LessNick/Astarta-ESP32/misc/ESP32-SIO.pdf

# ESP-32 connect Atari SIO

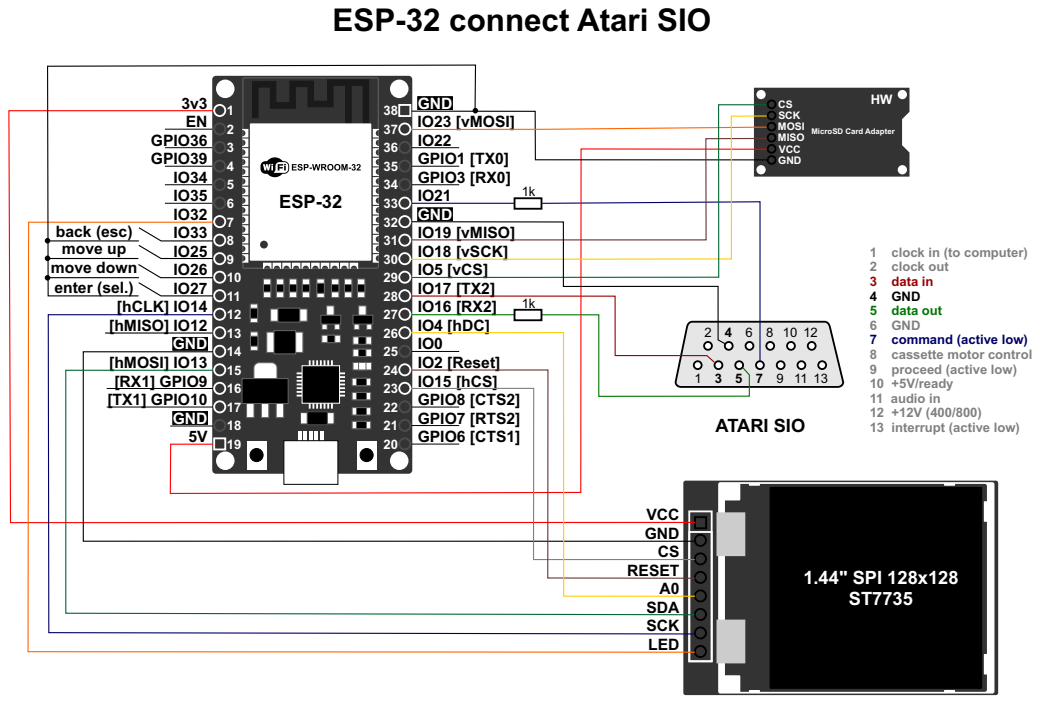
[picture p16: page 1]
3v3 EN GPIO36 GPIO39 IO34 IO35 IO32 IO33 IO25 IO26 IO27 [hCLK] IO14 [hMISO] IO12 GND [hMOSI] IO13 [RX1] GPIO9 [TX1] GPIO10 GND 5V; GND IO23 [vMOSI] IO22 GPIO1 [TX0] GPIO3 [RX0] IO21 GND IO19 [vMISO] IO18 [vSCK] IO5 [vCS]; IO4 [hDC] IO0 IO2 [Reset] IO15 [hCS]; GPIO7 [RTS2] GPIO6 [CTS1]; ESP-32; GPIO8 [CTS2]; ATARI SIO; 1.44" SPI 128x128 ST7735; VCC GND CS RESET A0 SDA SCK LED; enter (sel.); back (esc) move up move down; CS SCK MOSI MISO VCC GND

MicroSD Card Adapter

1 clock in (to computer)
2 clock out
3 data in
4 GND
5 data out
6 GND
7 command (active low)
8 cassette motor control
9 proceed (active low)
10 +5V/ready
11 audio in
13 interrupt (active low)

# Подключение ESP-32 к Atari

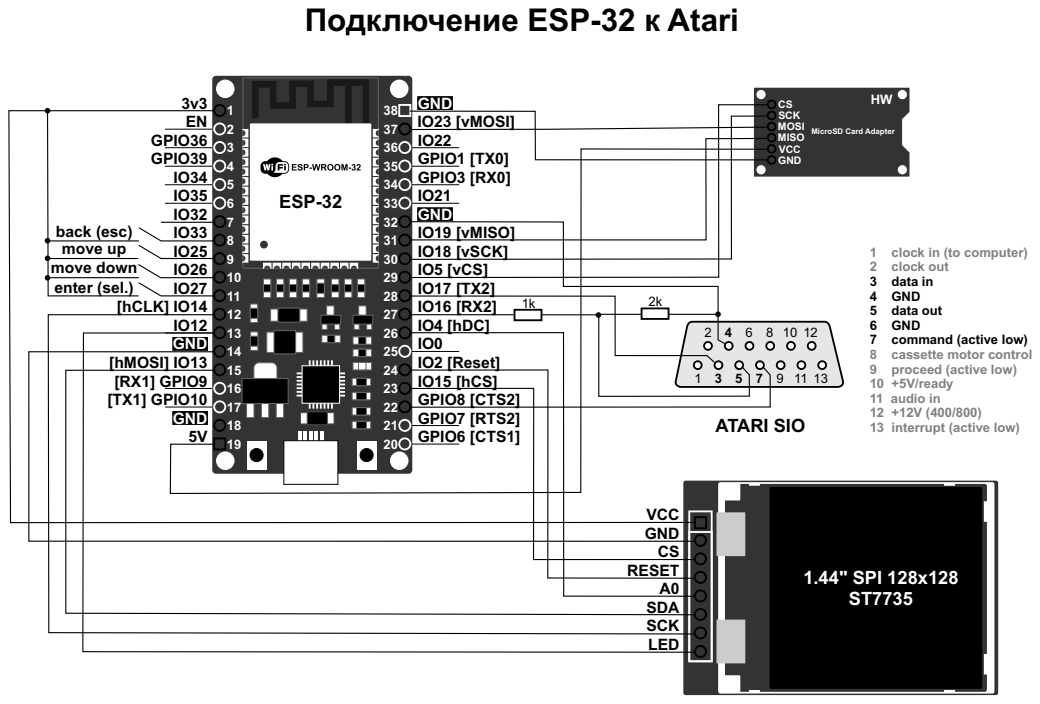
[picture p17: page 2]
3v3 EN GPIO36 GPIO39 IO34 IO35 IO32 IO33 IO25 IO26 IO27 [hCLK] IO14 IO12 GND [hMOSI] IO13 [RX1] GPIO9 [TX1] GPIO10 GND 5V; GND IO23 [vMOSI] IO22 GPIO1 [TX0] GPIO3 [RX0] IO21 GND IO19 [vMISO] IO18 [vSCK] IO5 [vCS]; IO4 [hDC] IO0 IO2 [Reset] IO15 [hCS]; GPIO7 [RTS2] GPIO6 [CTS1]; ESP-32; GPIO8 [CTS2]; ATARI SIO; 1.44" SPI 128x128 ST7735; VCC GND CS RESET A0 SDA SCK LED; enter (sel.); back (esc) move up move down; CS SCK MOSI MISO VCC GND

MicroSD Card Adapter

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
