LessNick/Astarta-ESP32/src/icons24_rgb.h

#ifndef ICONS24_h
#define ICONS24_h

const static uint8_t iconCassette[] = {
	0x95, 0xbe, 0x95, 0xbe, 0x95, 0xbe, 0x95, 0xbe, 0x95, 0xbe, 0x95, 0xbe, 0x95, 0xbe, 0x95, 0xbe, 0x95, 0xbe, 0x95, 0xbe, 0x95, 0xbe, 0x95, 0xbe, 0x95, 0xbe, 0x95, 0xbe, 0x95, 0xbe, 0x95, 0xbe, 0x95, 0xbe, 0x95, 0xbe, 0x95, 0xbe, 0x95, 0xbe, 0x95, 0xbe, 0x95, 0xbe, 0x95, 0xbe, 0x95, 0xbe, 
	0x95, 0xbe, 0x95, 0xbe, 0x95, 0xbe, 0x95, 0xbe, 0x95, 0xbe, 0x95, 0xbe, 0x95, 0xbe, 0x95, 0xbe, 0x95, 0xbe, 0x95, 0xbe, 0x95, 0xbe, 0x95, 0xbe, 0x95, 0xbe, 0x95, 0xbe, 0x95, 0xbe, 0x95, 0xbe, 0x95, 0xbe, 0x95, 0xbe, 0x95, 0xbe, 0x95, 0xbe, 0x95, 0xbe, 0x95, 0xbe, 0x95, 0xbe, 0x95, 0xbe, 
	0x95, 0xbe, 0x95, 0xbe, 0x95, 0xbe, 0x95, 0xbe, 0x95, 0xbe, 0x95, 0xbe, 0x95, 0xbe, 0x95, 0xbe, 0x95, 0xbe, 0x95, 0xbe, 0x95, 0xbe, 0x95, 0xbe, 0x95, 0xbe, 0x95, 0xbe, 0x95, 0xbe, 0x95, 0xbe, 0x95, 0xbe, 0x95, 0xbe, 0x95, 0xbe, 0x95, 0xbe, 0x95, 0xbe, 0x95, 0xbe, 0x95, 0xbe, 0x95, 0xbe, 
	0x95, 0xbe, 0x95, 0xbe, 0x95, 0xbe, 0x95, 0xbe, 0x95, 0xbe, 0x95, 0xbe, 0x95, 0xbe, 0x95, 0xbe, 0x95, 0xbe, 0x95, 0xbe, 0x95, 0xbe, 0x95, 0xbe, 0x95, 0xbe, 0x95, 0xbe, 0x95, 0xbe, 0x95, 0xbe, 0x95, 0xbe, 0x95, 0xbe, 0x95, 0xbe, 0x95, 0xbe, 0x95, 0xbe, 0x95, 0xbe, 0x95, 0xbe, 0x95, 0xbe, 
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
};

#endif
