LessNick/Astarta-ESP32/src/icons_rgb.h

#ifndef ICONS_h
#define ICONS_h

const static uint8_t iconCas0[] = {
	0x00, 0x00, 0x00, 0x00, 0x00, 0x00, 0x00, 0x00, 0x00, 0x00, 0x00, 0x00, 0x00, 0x00, 0x00, 0x00, 0x00, 0x00, 0x00, 0x00, 0x00, 0x00, 0x00, 0x00, 
	0x00, 0x00, 0x00, 0x00, 0x00, 0x00, 0x00, 0x00, 0x00, 0x00, 0x00, 0x00, 0x00, 0x00, 0x00, 0x00, 0x00, 0x00, 0x00, 0x00, 0x00, 0x00, 0x00, 0x00, 
	0x2a, 0x35, 0x2a, 0x35, 0x2a, 0x35, 0x2a, 0x35, 0x2a, 0x35, 0x2a, 0x35, 0x2a, 0x35, 0x2a, 0x35, 0x2a, 0x35, 0x2a, 0x35, 0x2a, 0x35, 0x2a, 0x35, 
	0x2a, 0x35, 0x64, 0x5c, 0x64, 0x5c, 0x64, 0x5c, 0x64, 0x5c, 0x64, 0x5c, 0x64, 0x5c, 0x64, 0x5c, 0x64, 0x5c, 0x64, 0x5c, 0x64, 0x5c, 0x2a, 0x35, 
	0x2a, 0x35, 0x64, 0x5c, 0x19, 0x50, 0x00, 0x00, 0x64, 0x5c, 0x64, 0x5c, 0x64, 0x5c, 0x64, 0x5c, 0x19, 0x50, 0x00, 0x00, 0x64, 0x5c, 0x2a, 0x35, 
	0x2a, 0x35, 0x64, 0x5c, 0x00, 0x00, 0x00, 0x00, 0x64, 0x5c, 0x43, 0x19, 0x43, 0x19, 0x64, 0x5c, 0x00, 0x00, 0x00, 0x00, 0x64, 0x5c, 0x2a, 0x35, 
	0x2a, 0x35, 0x64, 0x5c, 0x64, 0x5c, 0x64, 0x5c, 0x64, 0x5c, 0x64, 0x5c, 0x64, 0x5c, 0x64, 0x5c, 0x64, 0x5c, 0x64, 0x5c, 0x64, 0x5c, 0x2a, 0x35, 
	0x2a, 0x35, 0x2a, 0x35, 0x43, 0x19, 0x43, 0x19, 0x43, 0x19, 0x43, 0x19, 0x43, 0x19, 0x43, 0x19, 0x43, 0x19, 0x43, 0x19, 0x2a, 0x35, 0x2a, 0x35, 
	0x2a, 0x35, 0x43, 0x19, 0x2a, 0x35, 0x2a, 0x35, 0x2a, 0x35, 0x2a, 0x35, 0x2a, 0x35, 0x2a, 0x35, 0x2a, 0x35, 0x2a, 0x35, 0x43, 0x19, 0x2a, 0x35, 
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
	0x64, 0x5c, 0x64, 0x5c, 0x19, 0x50, 0x00, 0x00, 0x00, 0x00, 0x00, 0x00, 0x00, 0x00, 0x00, 0x00, 0x00, 0x00, 0x00, 0x00, 0x00, 0x00, 0x00, 0x00
};

#endif
