LessNick/Astarta-ESP32/src/icons.h

#ifndef ICONS_h
#define ICONS_h

static uint8_t const iconCas0[] = {
	0x00, 0x00, 0x00, 0x00, 0x00, 0x00, 0x00, 0x00, 0x00, 0x00, 0x00, 0x00, 0x00, 0x00, 0x00, 0x00, 0x00, 0x00, 0x00, 0x00, 0x00, 0x00, 0x00, 0x00, 
	0x00, 0x00, 0x00, 0x00, 0x00, 0x00, 0x00, 0x00, 0x00, 0x00, 0x00, 0x00, 0x00, 0x00, 0x00, 0x00, 0x00, 0x00, 0x00, 0x00, 0x00, 0x00, 0x00, 0x00, 
	0x35, 0x2a, 0x35, 0x2a, 0x35, 0x2a, 0x35, 0x2a, 0x35, 0x2a, 0x35, 0x2a, 0x35, 0x2a, 0x35, 0x2a, 0x35, 0x2a, 0x35, 0x2a, 0x35, 0x2a, 0x35, 0x2a, 
	0x35, 0x2a, 0x5c, 0x64, 0x5c, 0x64, 0x5c, 0x64, 0x5c, 0x64, 0x5c, 0x64, 0x5c, 0x64, 0x5c, 0x64, 0x5c, 0x64, 0x5c, 0x64, 0x5c, 0x64, 0x35, 0x2a, 
	0x35, 0x2a, 0x5c, 0x64, 0x50, 0x19, 0x00, 0x00, 0x5c, 0x64, 0x5c, 0x64, 0x5c, 0x64, 0x5c, 0x64, 0x50, 0x19, 0x00, 0x00, 0x5c, 0x64, 0x35, 0x2a, 
	0x35, 0x2a, 0x5c, 0x64, 0x00, 0x00, 0x00, 0x00, 0x5c, 0x64, 0x19, 0x43, 0x19, 0x43, 0x5c, 0x64, 0x00, 0x00, 0x00, 0x00, 0x5c, 0x64, 0x35, 0x2a, 
	0x35, 0x2a, 0x5c, 0x64, 0x5c, 0x64, 0x5c, 0x64, 0x5c, 0x64, 0x5c, 0x64, 0x5c, 0x64, 0x5c, 0x64, 0x5c, 0x64, 0x5c, 0x64, 0x5c, 0x64, 0x35, 0x2a, 
	0x35, 0x2a, 0x35, 0x2a, 0x19, 0x43, 0x19, 0x43, 0x19, 0x43, 0x19, 0x43, 0x19, 0x43, 0x19, 0x43, 0x19, 0x43, 0x19, 0x43, 0x35, 0x2a, 0x35, 0x2a, 
	0x35, 0x2a, 0x19, 0x43, 0x35, 0x2a, 0x35, 0x2a, 0x35, 0x2a, 0x35, 0x2a, 0x35, 0x2a, 0x35, 0x2a, 0x35, 0x2a, 0x35, 0x2a, 0x19, 0x43, 0x35, 0x2a, 
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
	0x5c, 0x64, 0x5c, 0x64, 0x50, 0x19, 0x00, 0x00, 0x00, 0x00, 0x00, 0x00, 0x00, 0x00, 0x00, 0x00, 0x00, 0x00, 0x00, 0x00, 0x00, 0x00, 0x00, 0x00
};

#endif
