LessNick/Astarta-ESP32/src/icons24.h

#ifndef ICONS24_h
#define ICONS24_h

static uint8_t const iconCassette[] = {
	0xbe, 0x95, 0xbe, 0x95, 0xbe, 0x95, 0xbe, 0x95, 0xbe, 0x95, 0xbe, 0x95, 0xbe, 0x95, 0xbe, 0x95, 0xbe, 0x95, 0xbe, 0x95, 0xbe, 0x95, 0xbe, 0x95, 0xbe, 0x95, 0xbe, 0x95, 0xbe, 0x95, 0xbe, 0x95, 0xbe, 0x95, 0xbe, 0x95, 0xbe, 0x95, 0xbe, 0x95, 0xbe, 0x95, 0xbe, 0x95, 0xbe, 0x95, 0xbe, 0x95, 
	0xbe, 0x95, 0xbe, 0x95, 0xbe, 0x95, 0xbe, 0x95, 0xbe, 0x95, 0xbe, 0x95, 0xbe, 0x95, 0xbe, 0x95, 0xbe, 0x95, 0xbe, 0x95, 0xbe, 0x95, 0xbe, 0x95, 0xbe, 0x95, 0xbe, 0x95, 0xbe, 0x95, 0xbe, 0x95, 0xbe, 0x95, 0xbe, 0x95, 0xbe, 0x95, 0xbe, 0x95, 0xbe, 0x95, 0xbe, 0x95, 0xbe, 0x95, 0xbe, 0x95, 
	0xbe, 0x95, 0xbe, 0x95, 0xbe, 0x95, 0xbe, 0x95, 0xbe, 0x95, 0xbe, 0x95, 0xbe, 0x95, 0xbe, 0x95, 0xbe, 0x95, 0xbe, 0x95, 0xbe, 0x95, 0xbe, 0x95, 0xbe, 0x95, 0xbe, 0x95, 0xbe, 0x95, 0xbe, 0x95, 0xbe, 0x95, 0xbe, 0x95, 0xbe, 0x95, 0xbe, 0x95, 0xbe, 0x95, 0xbe, 0x95, 0xbe, 0x95, 0xbe, 0x95, 
	0xbe, 0x95, 0xbe, 0x95, 0xbe, 0x95, 0xbe, 0x95, 0xbe, 0x95, 0xbe, 0x95, 0xbe, 0x95, 0xbe, 0x95, 0xbe, 0x95, 0xbe, 0x95, 0xbe, 0x95, 0xbe, 0x95, 0xbe, 0x95, 0xbe, 0x95, 0xbe, 0x95, 0xbe, 0x95, 0xbe, 0x95, 0xbe, 0x95, 0xbe, 0x95, 0xbe, 0x95, 0xbe, 0x95, 0xbe, 0x95, 0xbe, 0x95, 0xbe, 0x95, 
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
};

#endif
