LessNick/Astarta-ESP32/src/iconsRSSI_rgb.h

#ifndef ICONSRSSI_h
#define ICONSRSSI_h

const static uint8_t excellent[] = {
	0x19, 0x50, 0x19, 0x50, 0x19, 0x50, 0x19, 0x50, 0x19, 0x50, 0x19, 0x50, 0x19, 0x50, 0x19, 0x50, 0x19, 0x50, 0x19, 0x50, 0x19, 0x50, 0x19, 0x50, 0xbe, 0xbf, 0xbe, 0xbf, 
	0x19, 0x50, 0x19, 0x50, 0x19, 0x50, 0x19, 0x50, 0x19, 0x50, 0x19, 0x50, 0x19, 0x50, 0x19, 0x50, 0x19, 0x50, 0x19, 0x50, 0x19, 0x50, 0x19, 0x50, 0xbe, 0xbf, 0xbe, 0xbf, 
	0x19, 0x50, 0x19, 0x50, 0x19, 0x50, 0x19, 0x50, 0x19, 0x50, 0x19, 0x50, 0x19, 0x50, 0x19, 0x50, 0x19, 0x50, 0xbe, 0xbf, 0xbe, 0xbf, 0x19, 0x50, 0xbe, 0xbf, 0xbe, 0xbf, 
	0x19, 0x50, 0x19, 0x50, 0x19, 0x50, 0x19, 0x50, 0x19, 0x50, 0x19, 0x50, 0x19, 0x50, 0x19, 0x50, 0x19, 0x50, 0xbe, 0xbf, 0xbe, 0xbf, 0x19, 0x50, 0xbe, 0xbf, 0xbe, 0xbf, 
	0x19, 0x50, 0x19, 0x50, 0x19, 0x50, 0x19, 0x50, 0x19, 0x50, 0x19, 0x50, 0xbe, 0xbf, 0xbe, 0xbf, 0x19, 0x50, 0xbe, 0xbf, 0xbe, 0xbf, 0x19, 0x50, 0xbe, 0xbf, 0xbe, 0xbf, 
	0x19, 0x50, 0x19, 0x50, 0x19, 0x50, 0x19, 0x50, 0x19, 0x50, 0x19, 0x50, 0xbe, 0xbf, 0xbe, 0xbf, 0x19, 0x50, 0xbe, 0xbf, 0xbe, 0xbf, 0x19, 0x50, 0xbe, 0xbf, 0xbe, 0xbf, 
	0x19, 0x50, 0x19, 0x50, 0x19, 0x50, 0xbe, 0xbf, 0xbe, 0xbf, 0x19, 0x50, 0xbe, 0xbf, 0xbe, 0xbf, 0x19, 0x50, 0xbe, 0xbf, 0xbe, 0xbf, 0x19, 0x50, 0xbe, 0xbf, 0xbe, 0xbf, 
	0xbe, 0xbf, 0xbe, 0xbf, 0x19, 0x50, 0xbe, 0xbf, 0xbe, 0xbf, 0x19, 0x50, 0xbe, 0xbf, 0xbe, 0xbf, 0x19, 0x50, 0xbe, 0xbf, 0xbe, 0xbf, 0x19, 0x50, 0xbe, 0xbf, 0xbe, 0xbf
};

const static uint8_t none[] = {
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
	0xbe, 0xbf, 0xbe, 0xbf, 0x19, 0x50, 0xbe, 0xbf, 0xbe, 0xbf, 0x19, 0x50, 0xbe, 0xbf, 0xbe, 0xbf, 0x19, 0x50, 0xbe, 0xbf, 0xbe, 0xbf, 0x19, 0x50, 0x43, 0x19, 0x43, 0x19
};

#endif
