LessNick/Astarta-ESP32/src/iconsRSSI.h

#ifndef ICONSRSSI_h
#define ICONSRSSI_h

static uint8_t const none[] = {
	0x86, 0xc1, 0x86, 0xc1, 0x50, 0x19, 0x50, 0x19, 0x86, 0xc1, 0x86, 0xc1, 0x50, 0x19, 0x50, 0x19, 0x50, 0x19, 0x50, 0x19, 0x50, 0x19, 0x50, 0x19, 0x19, 0x43, 0x19, 0x43, 
	0x50, 0x19, 0x86, 0xc1, 0x86, 0xc1, 0x86, 0xc1, 0x86, 0xc1, 0x50, 0x19, 0x50, 0x19, 0x50, 0x19, 0x50, 0x19, 0x50, 0x19, 0x50, 0x19, 0x50, 0x19, 0x19, 0x43, 0x19, 0x43, 
	0x50, 0x19, 0x50, 0x19, 0x86, 0xc1, 0x86, 0xc1, 0x50, 0x19, 0x50, 0x19, 0x50, 0x19, 0x50, 0x19, 0x50, 0x19, 0x19, 0x43, 0x19, 0x43, 0x50, 0x19, 0x19, 0x43, 0x19, 0x43, 
	0x50, 0x19, 0x86, 0xc1, 0x86, 0xc1, 0x86, 0xc1, 0x86, 0xc1, 0x50, 0x19, 0x50, 0x19, 0x50, 0x19, 0x50, 0x19, 0x19, 0x43, 0x19, 0x43, 0x50, 0x19, 0x19, 0x43, 0x19, 0x43, 
	0x86, 0xc1, 0x86, 0xc1, 0x50, 0x19, 0x50, 0x19, 0x86, 0xc1, 0x86, 0xc1, 0x19, 0x43, 0x19, 0x43, 0x50, 0x19, 0x19, 0x43, 0x19, 0x43, 0x50, 0x19, 0x19, 0x43, 0x19, 0x43, 
	0x50, 0x19, 0x50, 0x19, 0x50, 0x19, 0x50, 0x19, 0x50, 0x19, 0x50, 0x19, 0x19, 0x43, 0x19, 0x43, 0x50, 0x19, 0x19, 0x43, 0x19, 0x43, 0x50, 0x19, 0x19, 0x43, 0x19, 0x43, 
	0x50, 0x19, 0x50, 0x19, 0x50, 0x19, 0x19, 0x43, 0x19, 0x43, 0x50, 0x19, 0x19, 0x43, 0x19, 0x43, 0x50, 0x19, 0x19, 0x43, 0x19, 0x43, 0x50, 0x19, 0x19, 0x43, 0x19, 0x43, 
	0x19, 0x43, 0x19, 0x43, 0x50, 0x19, 0x19, 0x43, 0x19, 0x43, 0x50, 0x19, 0x19, 0x43, 0x19, 0x43, 0x50, 0x19, 0x19, 0x43, 0x19, 0x43, 0x50, 0x19, 0x19, 0x43, 0x19, 0x43
};

static uint8_t const excellent[] = {
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
	0xbf, 0xbe, 0xbf, 0xbe, 0x50, 0x19, 0xbf, 0xbe, 0xbf, 0xbe, 0x50, 0x19, 0xbf, 0xbe, 0xbf, 0xbe, 0x50, 0x19, 0xbf, 0xbe, 0xbf, 0xbe, 0x50, 0x19, 0x19, 0x43, 0x19, 0x43
};

#endif
