LessNick/Astarta-ESP32/(commit log)

2023-01-04 Fixes + config loader
    [astarta.cfg]
2025-06-02 fixes & new implementations
    [config.h, dev.h, dispST7735.cpp, dispST7735.h, icons24_rgb.h, iconsRSSI_rgb.h, icons_rgb.h, keyboard.cpp]
